Tigran-teq-Tadevosyan/TIR/README.md

# TIR

The system facilitates two-way radio communication between devices with a physical network interface. Although it can be used to directly connect two devices with network capabilities, it can also bridge subnetworks. As it provides DHCP server capabil- ities, it is a plug and play system. The components of the system are portable, requiring low power usage, and can provide a connection in ranges over 10 km, so it can be a powerful tool for utilizing myriad networking technologies. All the details are available in the [paper](https://raw.githubusercontent.com/Tigran-teq-Tadevosyan/TIR/main/paper/Paper.pdf).

### Schematic Diagram of a Single Agent
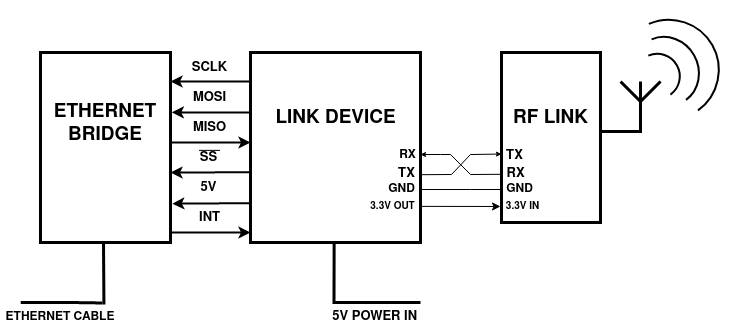
[picture p1: paper/Latex/schematic-diagram.png]


### Overview of System’s Packet Nesting Structure
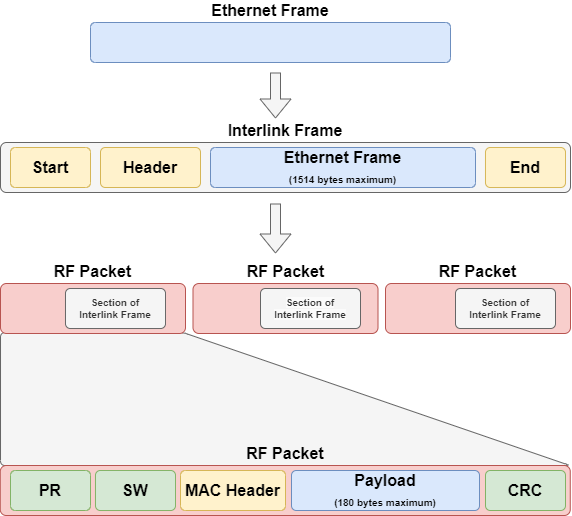
[picture p2: paper/Latex/packet-nesting.png]
