Tigran-teq-Tadevosyan/TIR/TIR-Application/main.cpp

#include <QGuiApplication>
#include <QQmlApplicationEngine>

#include <cstdio>

#include <arpa/inet.h>
#include <sys/socket.h>
#include <netinet/ip.h>
#include <pcap.h>


extern "C" {
    #include "Network/IP.h"
}

#define IPTOSBUFFERS    12
char *iptos(u_long in)
{
    static char output[IPTOSBUFFERS][3*4+3+1];
    static short which;
    u_char *p;

    p = (u_char *)&in;
    which = (which + 1 == IPTOSBUFFERS ? 0 : which + 1);
    snprintf(output[which], sizeof(output[which]),"%d.%d.%d.%d", p[0], p[1], p[2], p[3]);
    return output[which];
}


int main(int argc, char *argv[])
{
    QGuiApplication app(argc, argv);

    QQmlApplicationEngine engine;
    engine.addImportPath("qrc:/");

    const QUrl url("qrc:/Window.qml");
    QObject::connect(&engine, &QQmlApplicationEngine::objectCreated,
                     &app, [url](QObject *obj, const QUrl &objUrl) {
        if (!obj && url == objUrl)
            QCoreApplication::exit(-1);
    }, Qt::QueuedConnection);
    engine.load(url);

    return app.exec();
}
