Tigran-teq-Tadevosyan/TIR/TIR-Application/Network/CPU_Endian.h

#ifndef CPU_ENDIAN_H
#define CPU_ENDIAN_H

//#include "sys/_endian.h"

//Load unaligned 16-bit integer (little-endian encoding)
#define LOAD16LE(p) ( \
   ((uint16_t)(((uint8_t *)(p))[0]) << 0) | \
   ((uint16_t)(((uint8_t *)(p))[1]) << 8))

//Load unaligned 16-bit integer (big-endian encoding)
#define LOAD16BE(p) ( \
   ((uint16_t)(((uint8_t *)(p))[0]) << 8) | \
   ((uint16_t)(((uint8_t *)(p))[1]) << 0))

//Load unaligned 24-bit integer (little-endian encoding)
#define LOAD24LE(p) ( \
   ((uint32_t)(((uint8_t *)(p))[0]) << 0)| \
   ((uint32_t)(((uint8_t *)(p))[1]) << 8) | \
   ((uint32_t)(((uint8_t *)(p))[2]) << 16))

//Load unaligned 24-bit integer (big-endian encoding)
#define LOAD24BE(p) ( \
   ((uint32_t)(((uint8_t *)(p))[0]) << 16) | \
   ((uint32_t)(((uint8_t *)(p))[1]) << 8) | \
   ((uint32_t)(((uint8_t *)(p))[2]) << 0))

//Load unaligned 32-bit integer (little-endian encoding)
#define LOAD32LE(p) ( \
   ((uint32_t)(((uint8_t *)(p))[0]) << 0) | \
   ((uint32_t)(((uint8_t *)(p))[1]) << 8) | \
   ((uint32_t)(((uint8_t *)(p))[2]) << 16) | \
   ((uint32_t)(((uint8_t *)(p))[3]) << 24))

//Load unaligned 32-bit integer (big-endian encoding)
#define LOAD32BE(p) ( \
   ((uint32_t)(((uint8_t *)(p))[0]) << 24) | \
   ((uint32_t)(((uint8_t *)(p))[1]) << 16) | \
   ((uint32_t)(((uint8_t *)(p))[2]) << 8) | \
   ((uint32_t)(((uint8_t *)(p))[3]) << 0))

//Load unaligned 48-bit integer (little-endian encoding)
#define LOAD48LE(p) ( \
   ((uint64_t)(((uint8_t *)(p))[0]) << 0) | \
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
   ((uint8_t *)(p))[3] = ((uint64_t)(a) >> 24) & 0xFFU, \
   ((uint8_t *)(p))[4] = ((uint64_t)(a) >> 32) & 0xFFU, \
   ((uint8_t *)(p))[5] = ((uint64_t)(a) >> 40) & 0xFFU, \
   ((uint8_t *)(p))[6] = ((uint64_t)(a) >> 48) & 0xFFU, \
   ((uint8_t *)(p))[7] = ((uint64_t)(a) >> 56) & 0xFFU

//Store unaligned 64-bit integer (big-endian encoding)
#define STORE64BE(a, p) \
   ((uint8_t *)(p))[0] = ((uint64_t)(a) >> 56) & 0xFFU, \
   ((uint8_t *)(p))[1] = ((uint64_t)(a) >> 48) & 0xFFU, \
   ((uint8_t *)(p))[2] = ((uint64_t)(a) >> 40) & 0xFFU, \
   ((uint8_t *)(p))[3] = ((uint64_t)(a) >> 32) & 0xFFU, \
   ((uint8_t *)(p))[4] = ((uint64_t)(a) >> 24) & 0xFFU, \
   ((uint8_t *)(p))[5] = ((uint64_t)(a) >> 16) & 0xFFU, \
   ((uint8_t *)(p))[6] = ((uint64_t)(a) >> 8) & 0xFFU, \
   ((uint8_t *)(p))[7] = ((uint64_t)(a) >> 0) & 0xFFU

//Swap a 16-bit integer
#define SWAPINT16(x) ( \
   (((uint16_t)(x) & 0x00FFU) << 8) | \
   (((uint16_t)(x) & 0xFF00U) >> 8))

//Swap a 32-bit integer
#define SWAPINT32(x) ( \
   (((uint32_t)(x) & 0x000000FFUL) << 24) | \
   (((uint32_t)(x) & 0x0000FF00UL) << 8) | \
   (((uint32_t)(x) & 0x00FF0000UL) >> 8) | \
   (((uint32_t)(x) & 0xFF000000UL) >> 24))

//Swap a 64-bit integer
#define SWAPINT64(x) ( \
   (((uint64_t)(x) & 0x00000000000000FFULL) << 56) | \
   (((uint64_t)(x) & 0x000000000000FF00ULL) << 40) | \
   (((uint64_t)(x) & 0x0000000000FF0000ULL) << 24) | \
   (((uint64_t)(x) & 0x00000000FF000000ULL) << 8) | \
   (((uint64_t)(x) & 0x000000FF00000000ULL) >> 8) | \
   (((uint64_t)(x) & 0x0000FF0000000000ULL) >> 24) | \
   (((uint64_t)(x) & 0x00FF000000000000ULL) >> 40) | \
   (((uint64_t)(x) & 0xFF00000000000000ULL) >> 56))

//Host byte order to network byte order
#undef HTONS
#undef HTONL
#undef HTONLL

#define HTONS(value) SWAPINT16(value)
#define HTONL(value) SWAPINT32(value)
#define HTONLL(value) SWAPINT64(value)


#endif // CPU_ENDIAN_H
