Tigran-teq-Tadevosyan/TIR/(commit log)

2023-05-05 Interrupt solution for w5500
    Initial part of migration to interrupt based solution for W5500
2023-05-08 Added DHCP maintenance and fixed TxFIFO memory leak
    [Common.c, Common.h, DHCP_Server.c, DHCP_Server.h, W5500.c, main.c]
2023-05-12 Added timeout to UART2 read
2023-05-12 Vahagn Changes
    SPI blocking, speed 20 MBPS
    Write and Send are seperate for W5500
    Interlink packet length check
2023-05-13 Finished buffer restructt aand fixed reading from W5500
    [DHCP_Server.c, DHCP_Server.h, Debug.c, Debug.h, W5500.c]
2023-05-14 Fixed interlinkBuffer bug, initial transition to DMA on interlink TX
    [BufferPktQueue.c, BufferPktQueue.h, Common.c, Common.h, DHCP_Server.h, Debug.c, Debug.h]
2023-05-14 Finished DMA uart tx
2023-05-15 Finished transistion to DMA
2023-05-15 RF almost done
    - Separated MAC, PHY
    - Code clean-up
    KNOWSN ISSUES: two way communication has some problems
    [TIR-RF.c, mac.c, mac.h, phy.c, phy.h, system_timer.c, system_timer.h, uart.c]
2023-05-17 Implemented TDMA
    - Lowered UART baud rate to 230400
    - Improvements on synchronization
    - Two way communication
