Tigran-teq-Tadevosyan/TIR/(notices)

Notices in the files:
TIR-Link/firmware/src/W5500/driver/Ethernet/socket.c:
Copyright (c) 2013, WIZnet Co., LTD.
All rights reserved.
